microfarad-de/water-sensor/doc/water-sensor-schematic.pdf

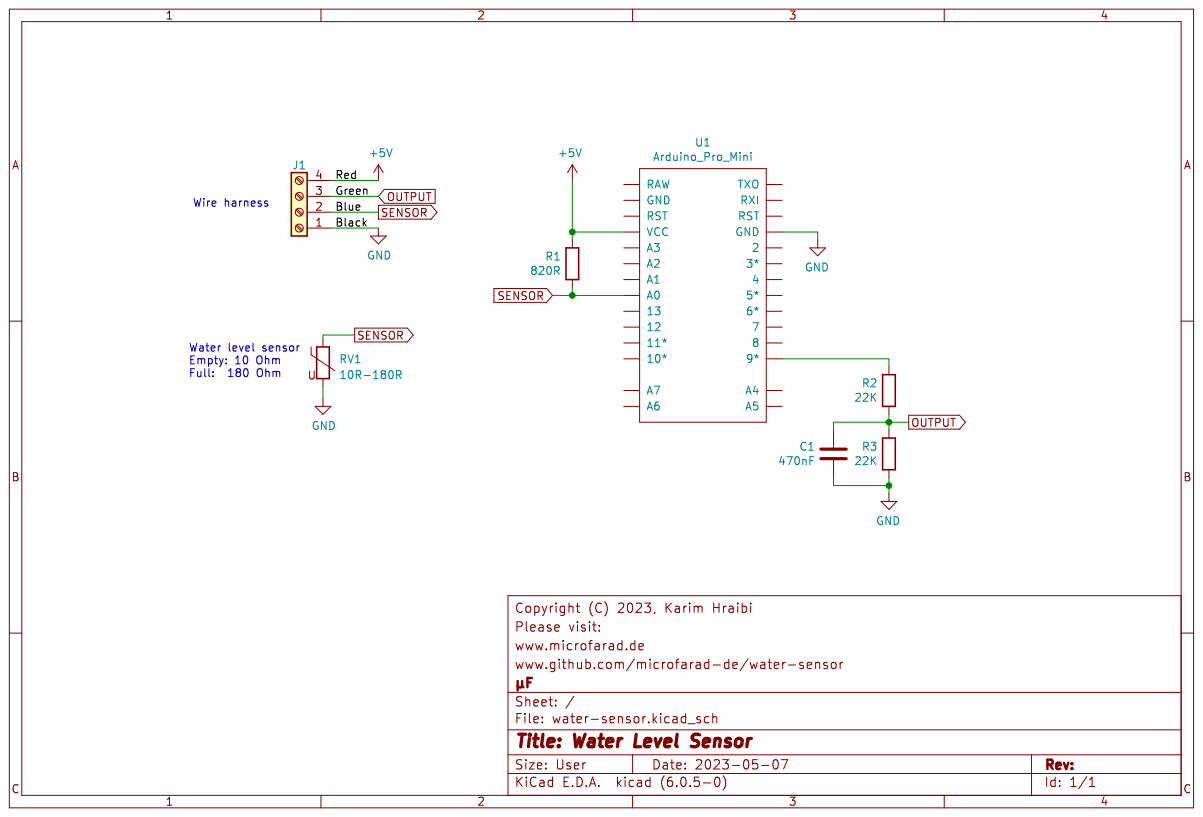
[picture p4: page 1]
