microfarad-de/water-sensor/(commit log)

2022-03-08 Added the FIX_PWM macro
    [water-sensor.ino]
2022-03-08 Tested on Arduino
2022-03-10 Implemented capacitive measurement method.
2022-03-12 Schematic and pictures
2022-03-12 Updated schematic
2022-03-14 Optional calibration using absolute ADC values
2023-05-07 Reworked for using 10-180 Ohm standard level sensors.
    [water-sensor.ino]
2023-05-07 Advanced Nvm validation Use Vcc for ADC reference voltage
2023-05-07 Fix ADC default values
    [water-sensor.ino]
