microfarad-de/water-sensor/doc/perspective-2.jpg

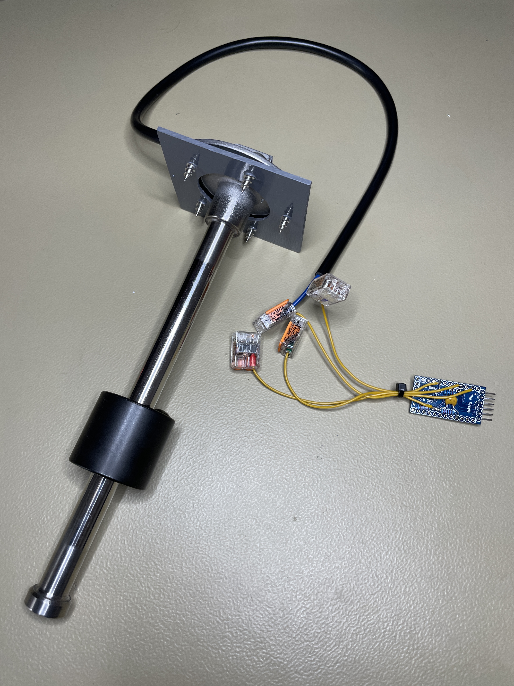
[picture p3: doc/perspective-2.jpg]
doc/perspective-2.jpg
